Ahmed0Sherif/RP2040_Board/RP2040V1.0.pdf

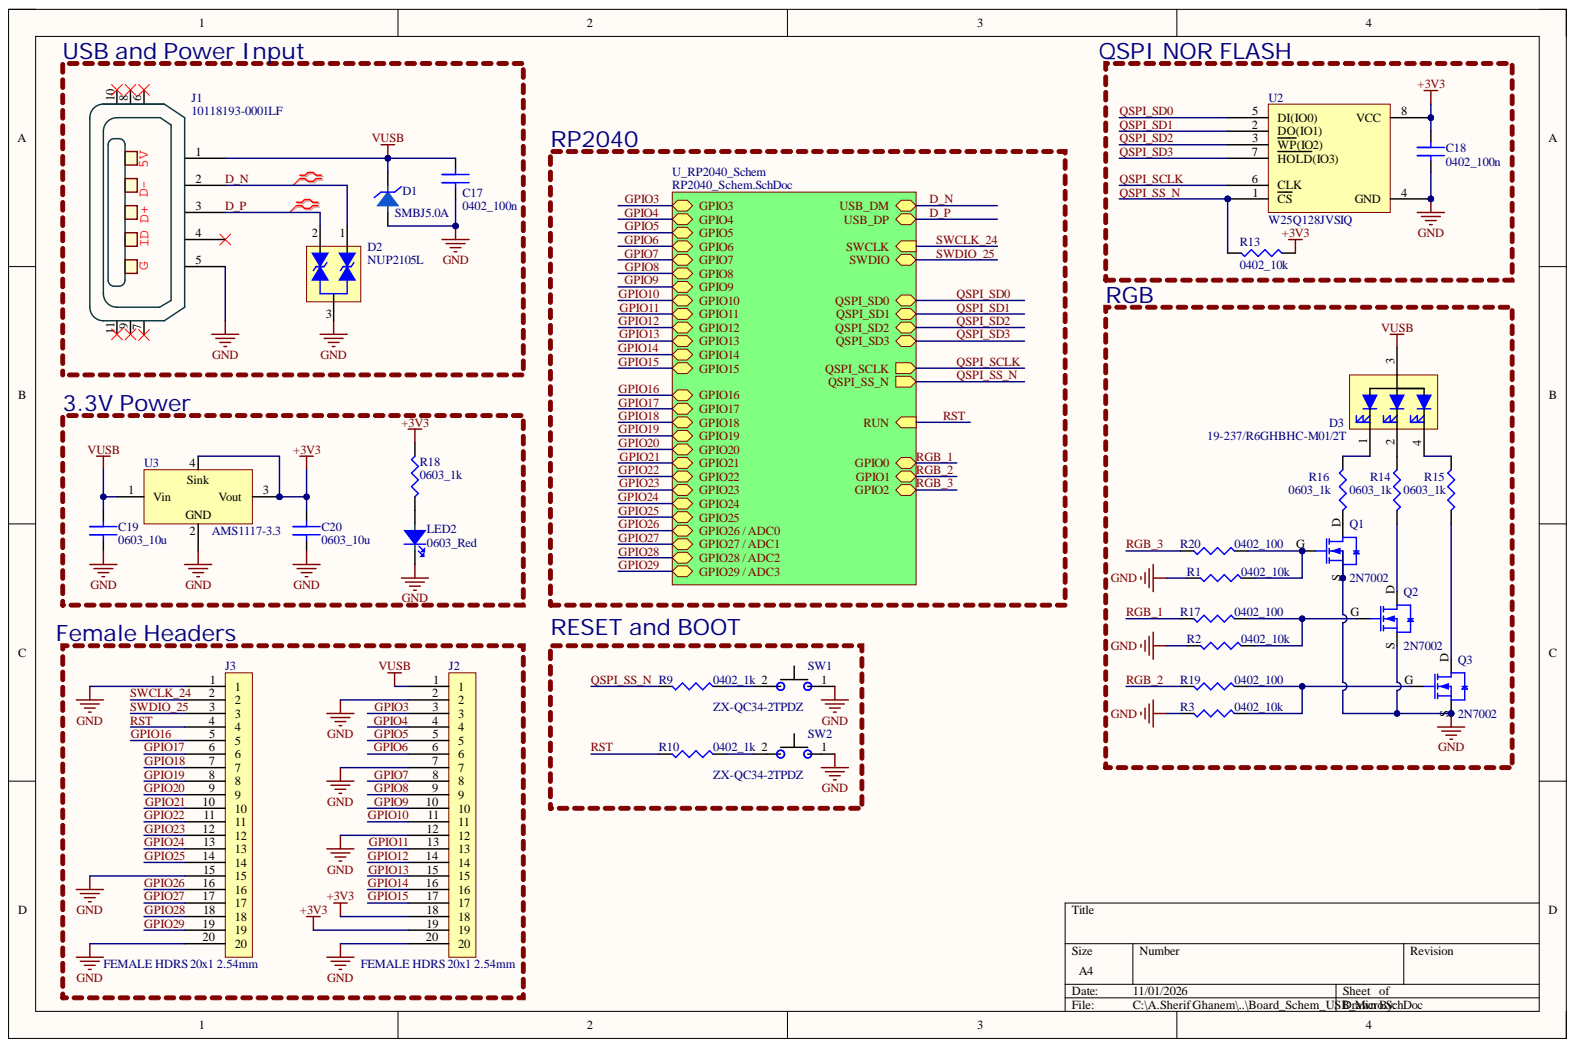
[picture p15: page 1]

USB and Power Input

Da te : 11/01/20 2 6 | She et of
File : C:\A. She rif Ghanem\. .\Boa rd_S chem_US | BDr_Mawn icr oB. Syc: hD o c

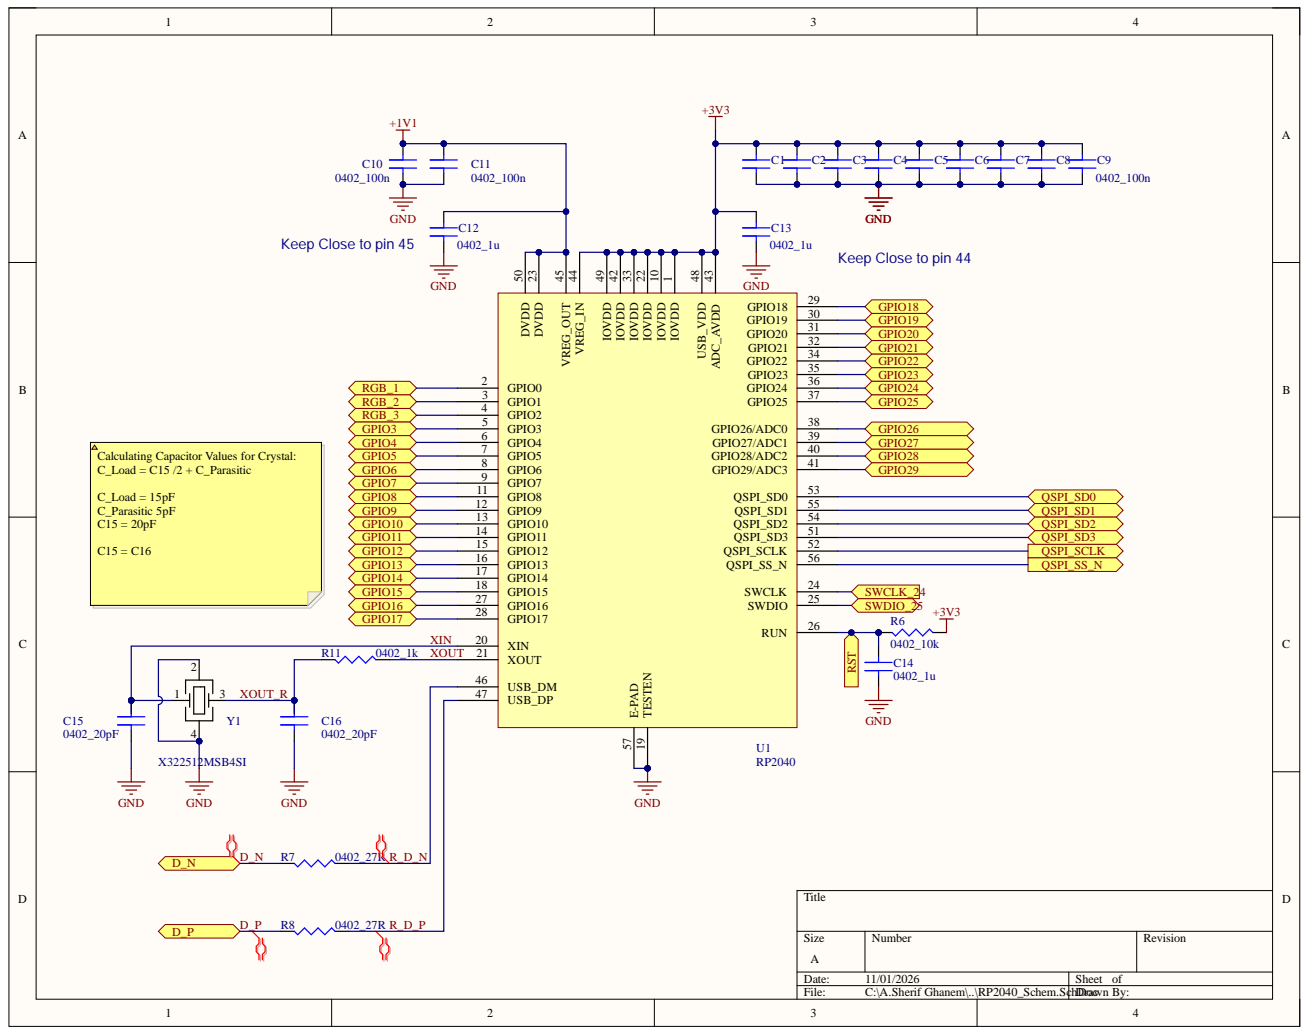
[picture p16: page 2]

Keep Close to pin 44 Keep Close to pin 45

Calculating Capacitor Values for Crystal:
C_Load = C15 /2 + C_Parasitic

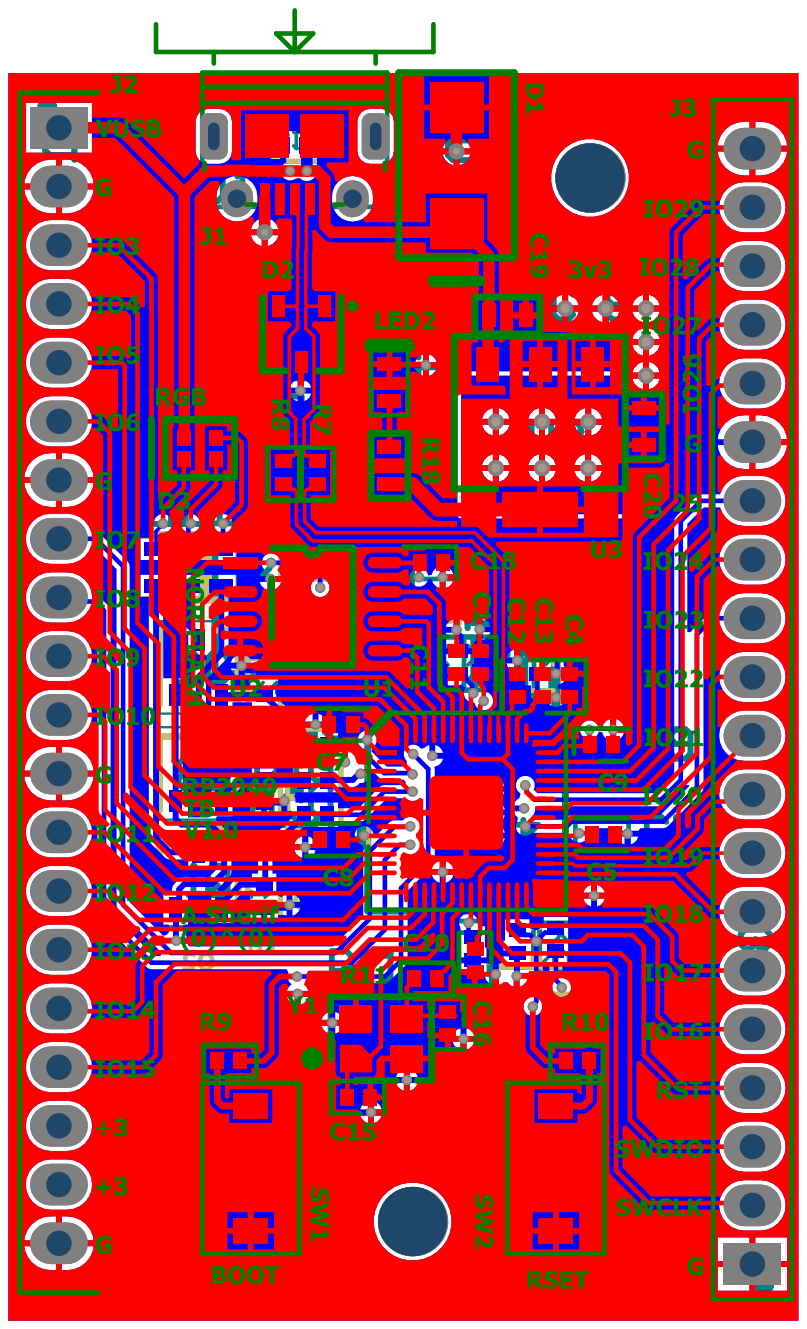
[picture p17: page 3]
