Ahmed0Sherif/RP2040_Board/(list of files, drawings)

Other design files:
Board_Schem_USB_Micro.SchDoc
RP2040_PCB_V1T1.PcbDoc
RP2040_Schem.SchDoc
RP2040V1.0.PrjPcb
RP_Components.SchLib
RP_Models.PcbLib
TimerSMD_Components.SchLib
TimerSMD_Models.PcbLib
