Ahmed0Sherif/RP2040_Board/(commit log)

2026-10-30 Added Project Files
    [Board_Schem_USB_Micro.SchDoc, RP2040V1.0.PrjPcb, RP2040_PCB_V1T1.PcbDoc, RP2040_Schem.SchDoc, RP_Components.SchLib, RP_Models.PcbLib, TimerSMD_Components.SchLib, TimerSMD_Models.PcbLib]
2026-11-01 Updated files + schem fixes + PCB fixes
    [Board_Schem_USB_Micro.SchDoc, RP2040V1.0.PrjPcb, RP2040_PCB_V1T1.PcbDoc, RP2040_Schem.SchDoc]
2026-11-01 Schematic fixes + PCB fixes
2026-11-01 Updated Schematic + USB + Added pdf
    [Board_Schem_USB_Micro.SchDoc]
